mr258876/PRISM-Film-Scanner/Resources/Imaging_Board_PoC.jpg

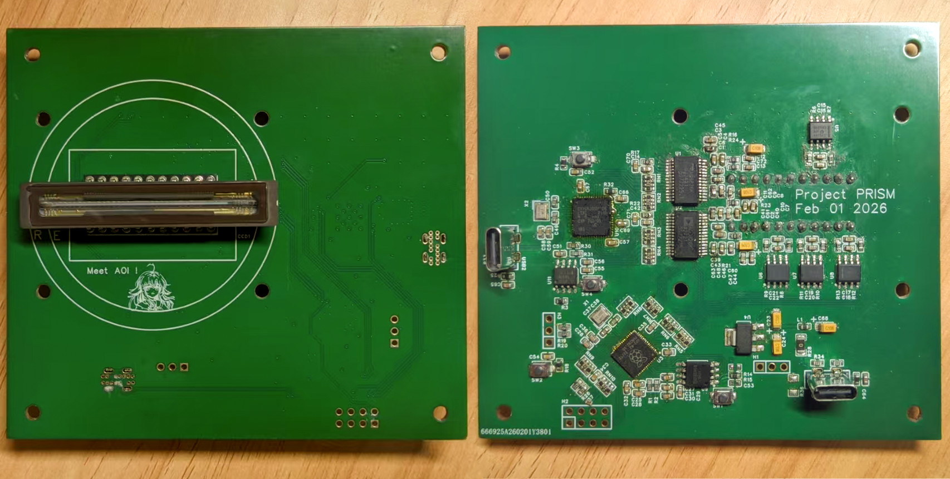
Resources/Imaging_Board_PoC.jpg
