mr258876/PRISM-Film-Scanner/103_Gantry_Framework/FrameCarrier.SLDASM

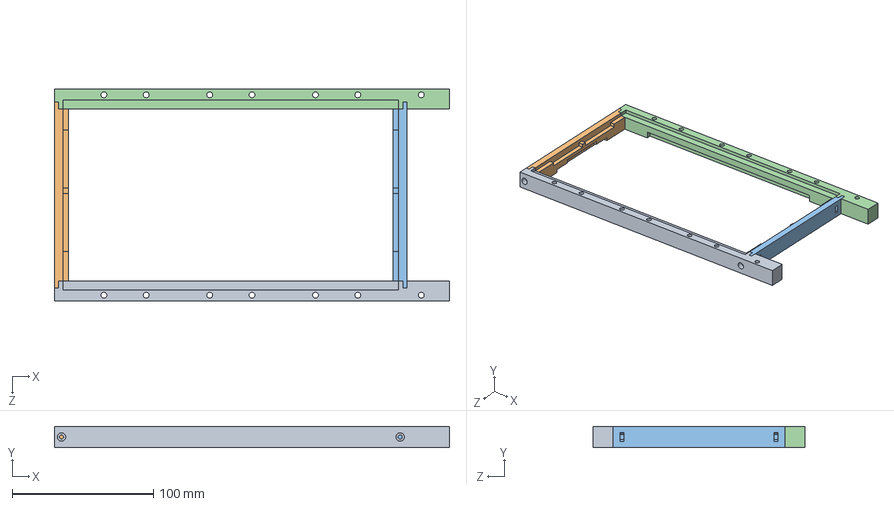
[picture p7: CAD file, 2026-05-15]
103_Gantry_Framework/FrameCarrier.SLDASM
280.0 x 15.0 x 150.0 mm
Film Carrier Frame D
Film Carrier Frame L
Film Carrier Frame R
Film Carrier Frame T
