mr258876/PRISM-Film-Scanner/103_Gantry_Framework/Framework.SLDASM

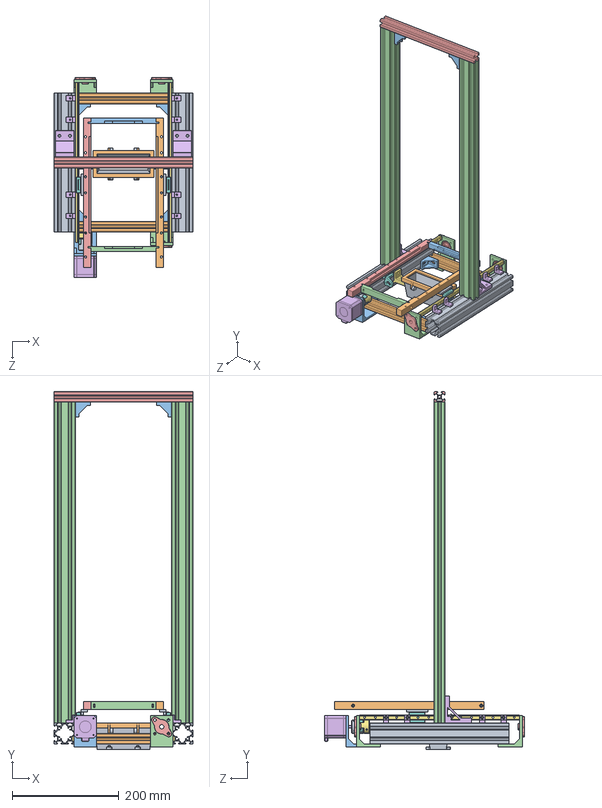
[picture p8: CAD file, 2026-05-15]
103_Gantry_Framework/Framework.SLDASM
260.0 x 670.0 x 374.0 mm
TXCJ-H7-4420-L260 x 2
TXCJ-H7-2020-L180 x 2
TPDB-206-2020-ZP x 6
TXCJ-H7-2040-L600 x 2
TXCJ-H7-2020-L260
Stands x 8
导轨^MGN9C-1-R-300-Z0-C-E10 x 2
滑块^MGN9C-1-R-300-Z0-C-E10 x 2
Film Carrier Frame Support x 2
Film Carrier Frame D
Film Carrier Frame L
Film Carrier Frame R
Film Carrier Frame T
TPDC3-206-5034-ZP x 2
Diffuser Support x 2
Film Carrier Flange Ring x 2
Diffuser
Diffuser Cap
Motor Mount
Screw Mount x 3
KFL08 x 3
42Stepper
主体1^CXHH-D25-d5-e8
调节环^CXHH-D25-d5-e8
主体2^CXHH-D25-d5-e8
