mr258876/PRISM-Film-Scanner/103_Gantry_Framework/MGN9C-1-R-300-Z0-C-E10.sldasm

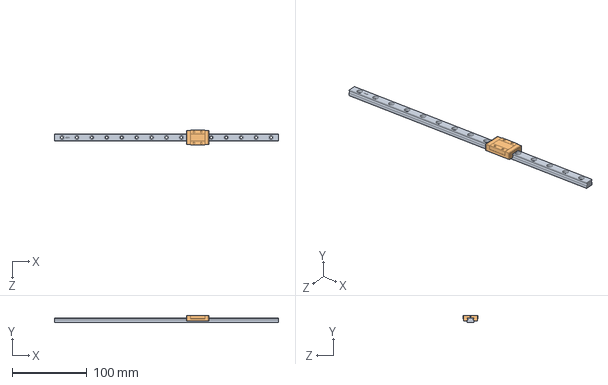
[picture p9: CAD file, 2026-05-15]
103_Gantry_Framework/MGN9C-1-R-300-Z0-C-E10.sldasm
300.0 x 10.0 x 20.0 mm
导轨^MGN9C-1-R-300-Z0-C-E10
滑块^MGN9C-1-R-300-Z0-C-E10
