mr258876/PRISM-Film-Scanner/103_Gantry_Framework/42Stepper.SLDPRT

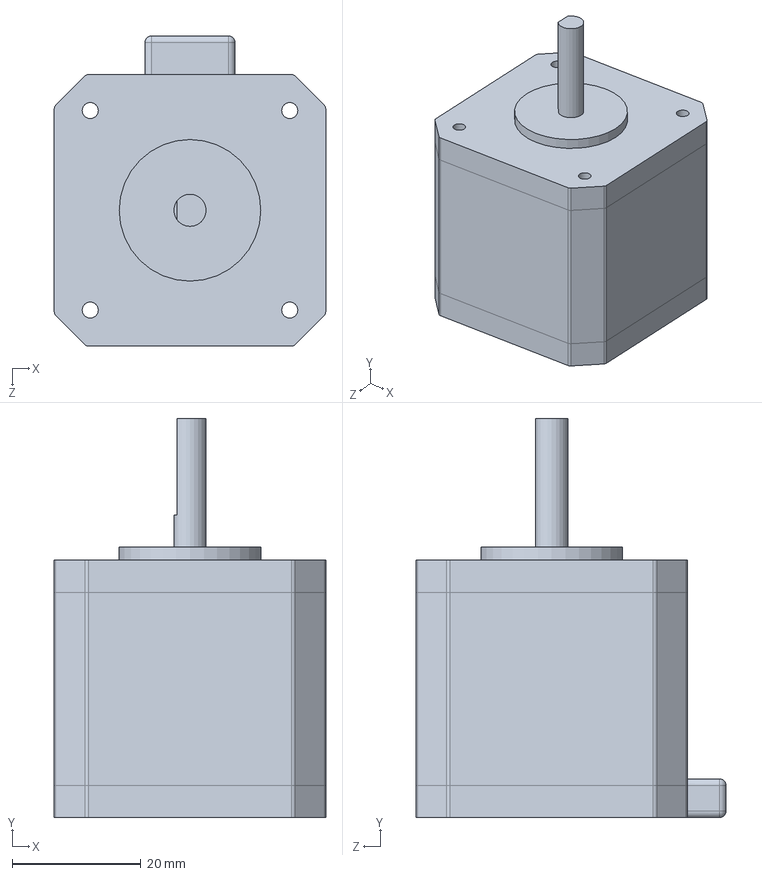
[picture p10: CAD file, 2026-05-15]
103_Gantry_Framework/42Stepper.SLDPRT
42.2 x 62.0 x 48.2 mm
