mr258876/PRISM-Film-Scanner/Lens Adapter/E-Adapter.STEP

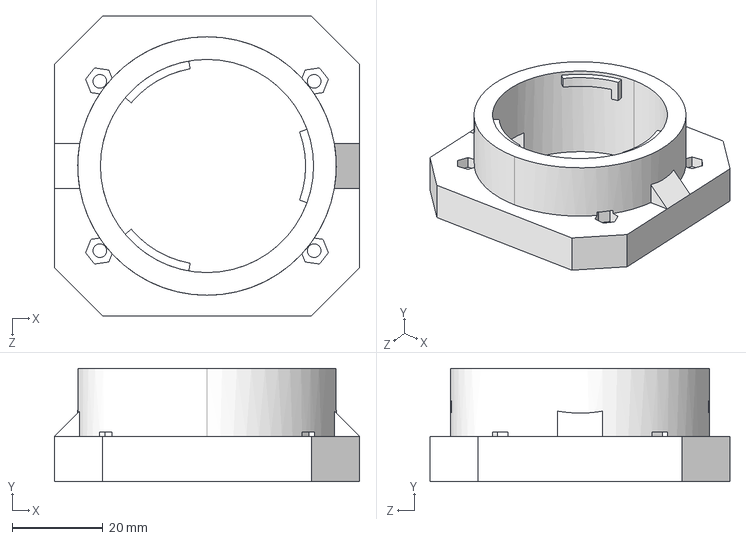
[picture p11: CAD file, 2026-03-14]
Lens Adapter/E-Adapter.STEP
67.2 x 25.0 x 66.1 mm
