mr258876/PRISM-Film-Scanner/103_Gantry_Framework/Film Carrier Frame T.SLDPRT

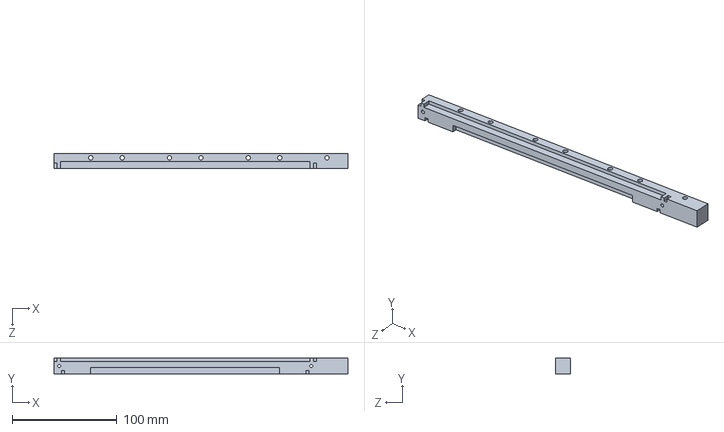
[picture p12: CAD file, 2026-05-15]
103_Gantry_Framework/Film Carrier Frame T.SLDPRT
280.0 x 15.0 x 14.0 mm
