mr258876/PRISM-Film-Scanner/103_Gantry_Framework/Film Carrier Frame.SLDPRT

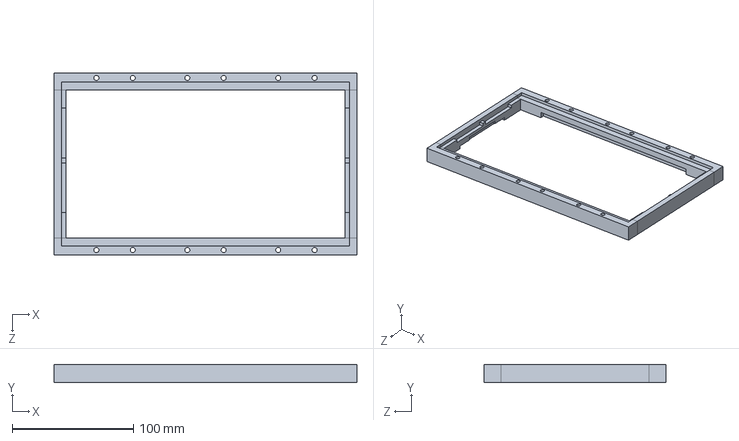
[picture p13: CAD file, 2026-05-15]
103_Gantry_Framework/Film Carrier Frame.SLDPRT
250.0 x 15.0 x 150.0 mm
