mr258876/PRISM-Film-Scanner/103_Gantry_Framework/TXCJ-H7-2040-L600.sldprt

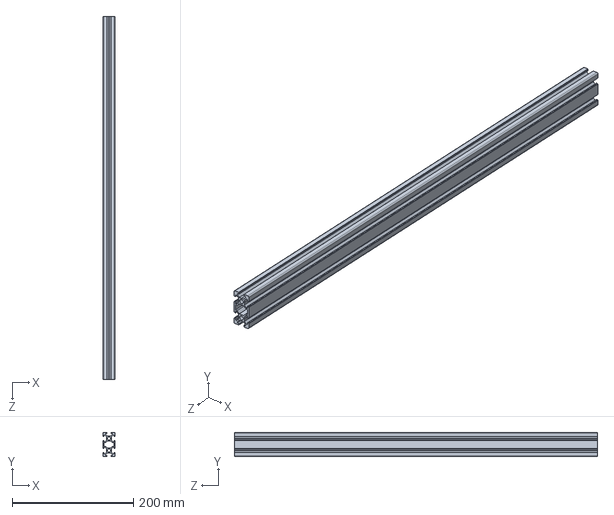
[picture p14: CAD file, 2026-05-15]
103_Gantry_Framework/TXCJ-H7-2040-L600.sldprt
20.0 x 40.0 x 600.0 mm
