mr258876/PRISM-Film-Scanner/103_Gantry_Framework/Scanner Mount.SLDPRT

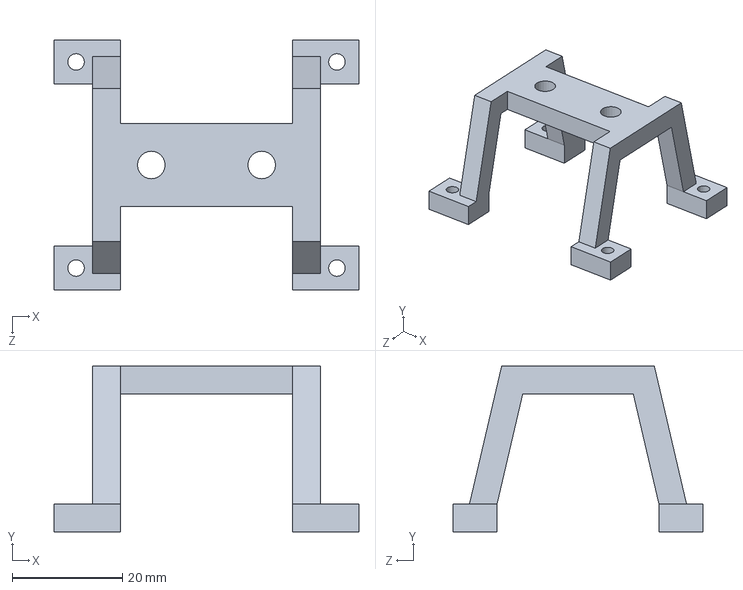
[picture p15: CAD file, 2026-05-15]
103_Gantry_Framework/Scanner Mount.SLDPRT
55.2 x 30.0 x 45.3 mm
