mr258876/PRISM-Film-Scanner/103_Gantry_Framework/Film Carrier Frame R.SLDPRT

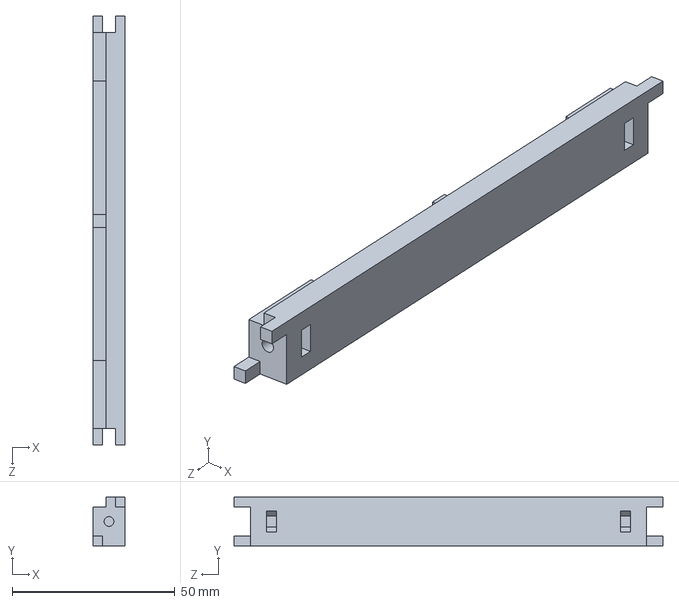
[picture p16: CAD file, 2026-05-15]
103_Gantry_Framework/Film Carrier Frame R.SLDPRT
10.00 x 15.0 x 132.0 mm
