mr258876/PRISM-Film-Scanner/103_Gantry_Framework/Diffuser.SLDPRT

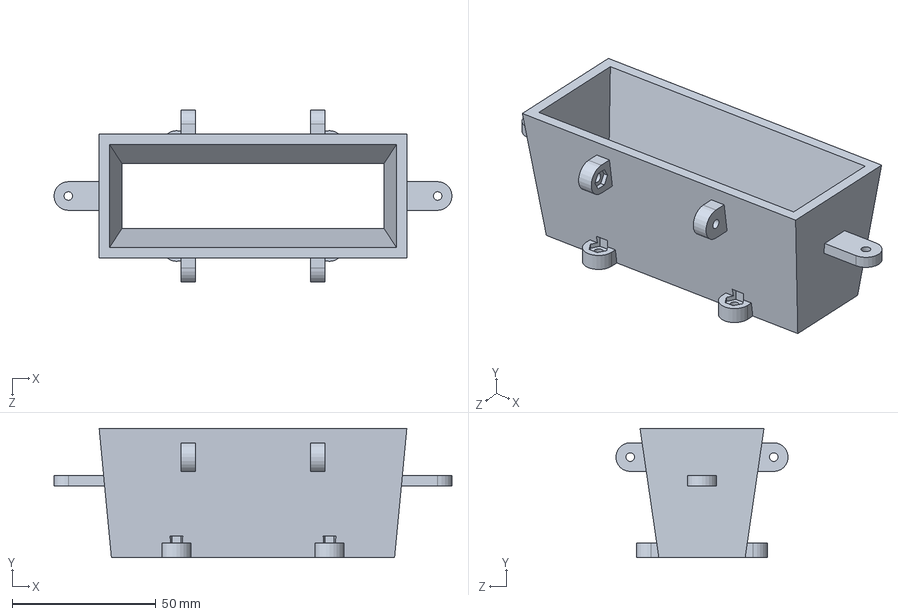
[picture p17: CAD file, 2026-05-15]
103_Gantry_Framework/Diffuser.SLDPRT
138.6 x 45.0 x 60.0 mm
