mr258876/PRISM-Film-Scanner/103_Gantry_Framework/TPDB-206-2020-ZP.sldprt

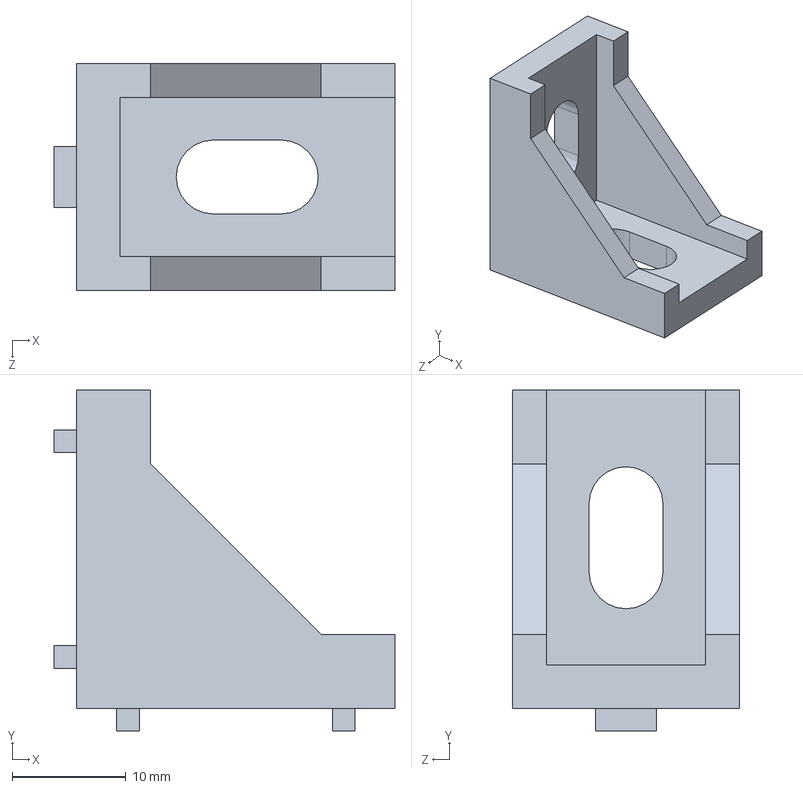
[picture p18: CAD file, 2026-05-15]
103_Gantry_Framework/TPDB-206-2020-ZP.sldprt
30.0 x 30.0 x 20.0 mm
