mr258876/PRISM-Film-Scanner/103_Gantry_Framework/Diffuser Support.SLDPRT

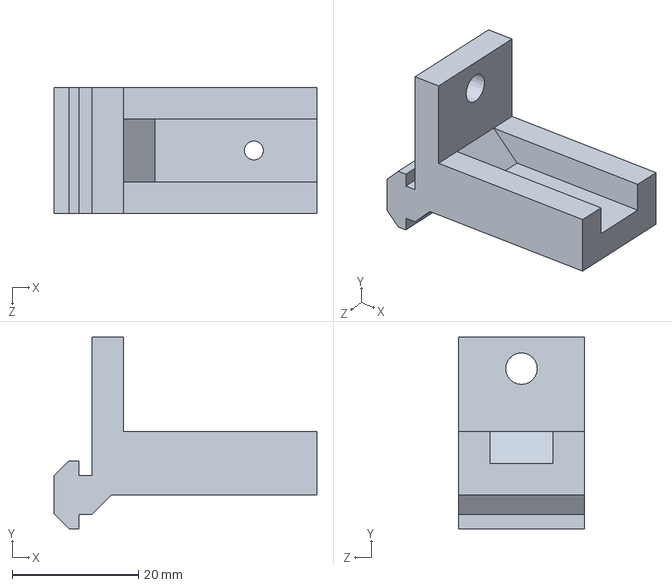
[picture p19: CAD file, 2026-05-15]
103_Gantry_Framework/Diffuser Support.SLDPRT
41.7 x 30.4 x 20.0 mm
