mr258876/PRISM-Film-Scanner/103_Gantry_Framework/TPDC3-206-5034-ZP.sldprt

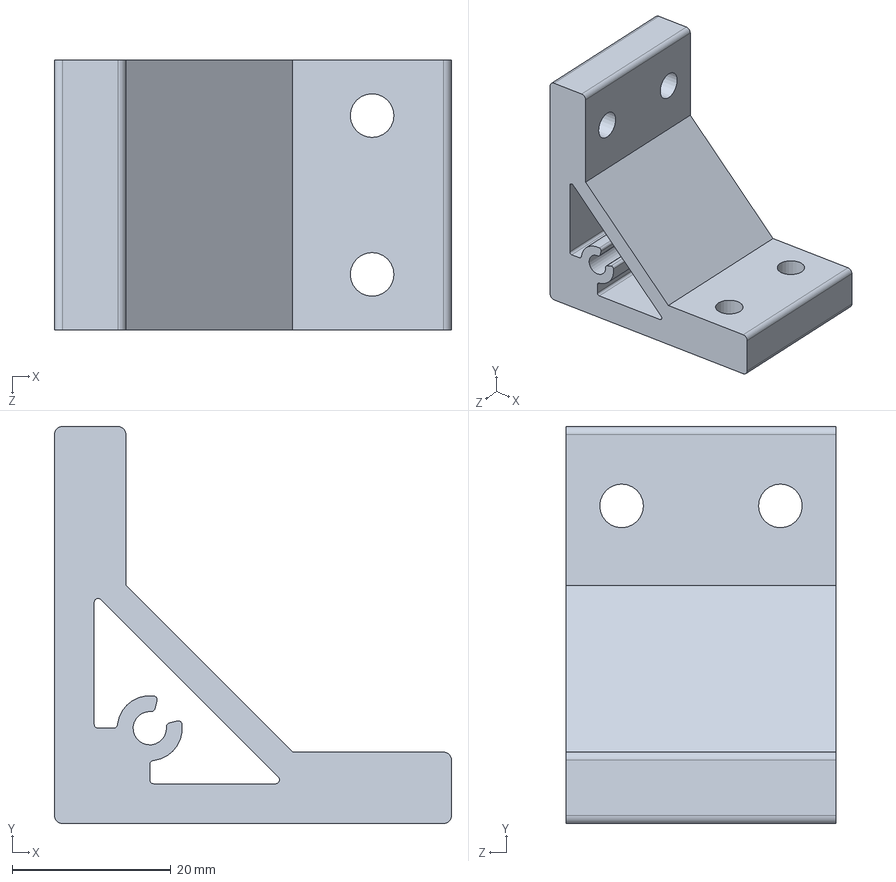
[picture p20: CAD file, 2026-05-15]
103_Gantry_Framework/TPDC3-206-5034-ZP.sldprt
50.0 x 50.0 x 34.0 mm
