mr258876/PRISM-Film-Scanner/103_Gantry_Framework/Film Carrier 35mm.SLDPRT

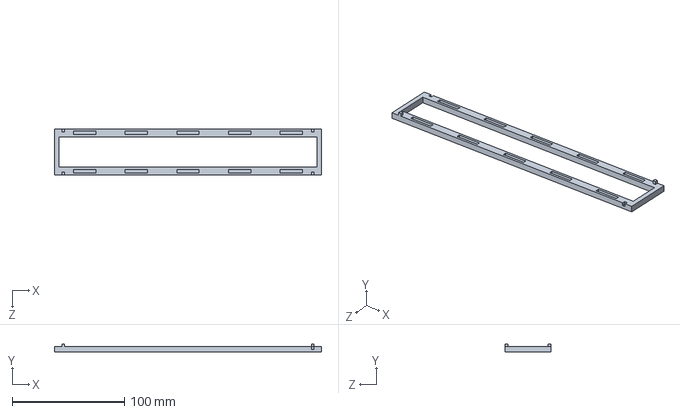
[picture p21: CAD file, 2026-05-15]
103_Gantry_Framework/Film Carrier 35mm.SLDPRT
238.0 x 7.50 x 41.0 mm
