mr258876/PRISM-Film-Scanner/103_Gantry_Framework/KFL08.SLDPRT

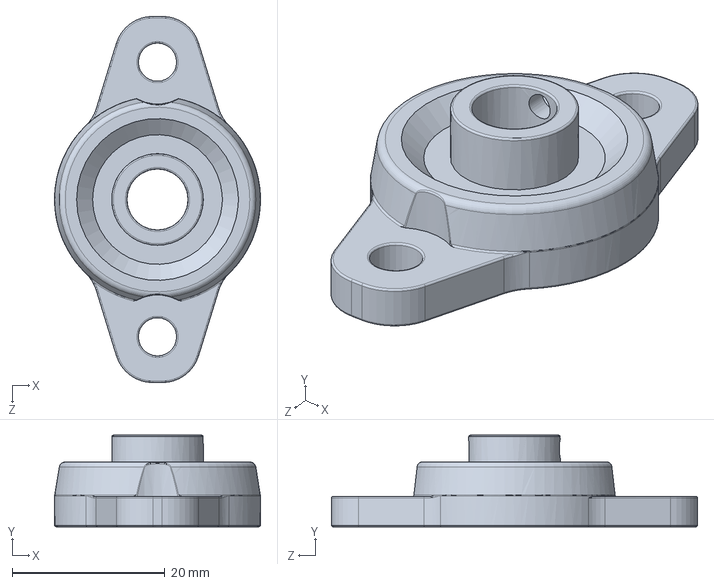
[picture p22: CAD file, 2026-05-15]
103_Gantry_Framework/KFL08.SLDPRT
27.0 x 12.0 x 48.0 mm
