mr258876/PRISM-Film-Scanner/103_Gantry_Framework/TXCJ-H7-2020-L260.sldprt

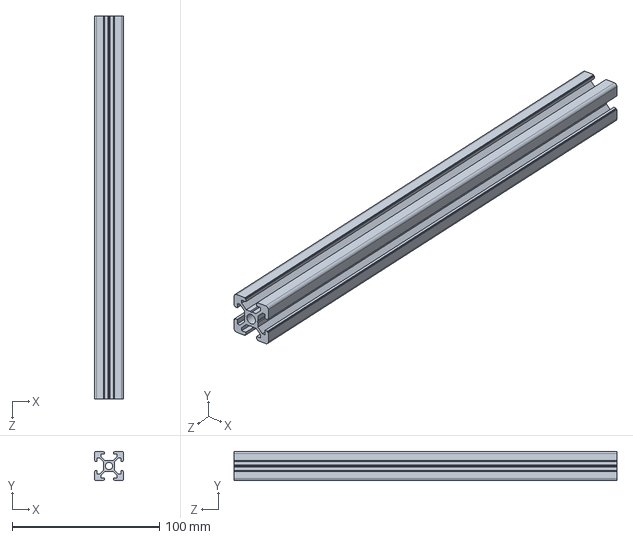
[picture p23: CAD file, 2026-05-15]
103_Gantry_Framework/TXCJ-H7-2020-L260.sldprt
20.0 x 20.0 x 260.0 mm
