mr258876/PRISM-Film-Scanner/103_Gantry_Framework/Diffuser Cap.SLDPRT

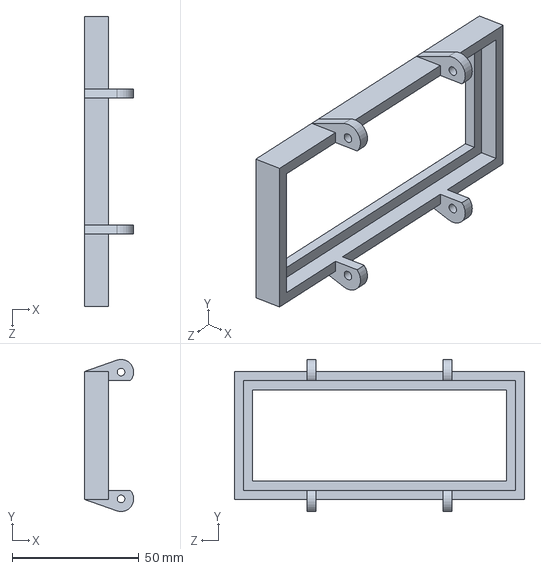
[picture p24: CAD file, 2026-05-15]
103_Gantry_Framework/Diffuser Cap.SLDPRT
19.5 x 60.0 x 114.4 mm
