mr258876/PRISM-Film-Scanner/103_Gantry_Framework/TXCJ-H7-4420-L260.sldprt

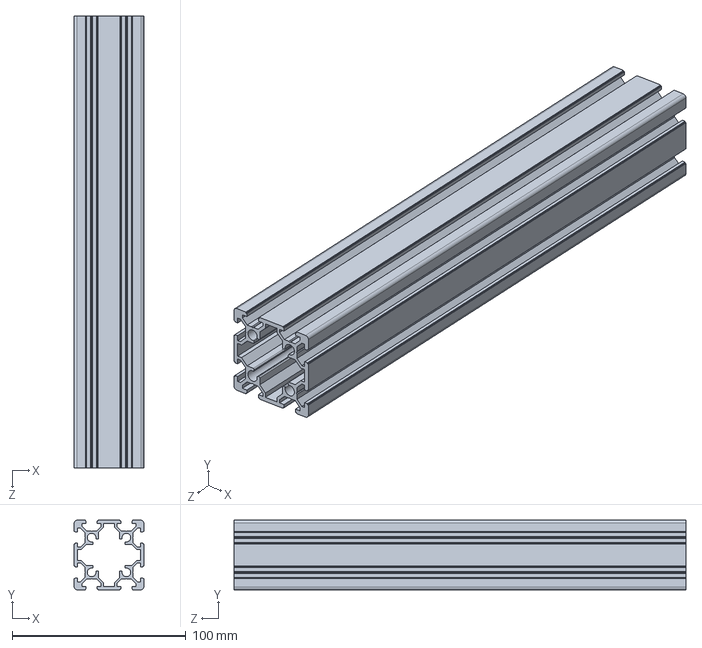
[picture p25: CAD file, 2026-05-15]
103_Gantry_Framework/TXCJ-H7-4420-L260.sldprt
40.0 x 40.0 x 260.0 mm
