mr258876/PRISM-Film-Scanner/103_Gantry_Framework/Motor Mount.SLDPRT

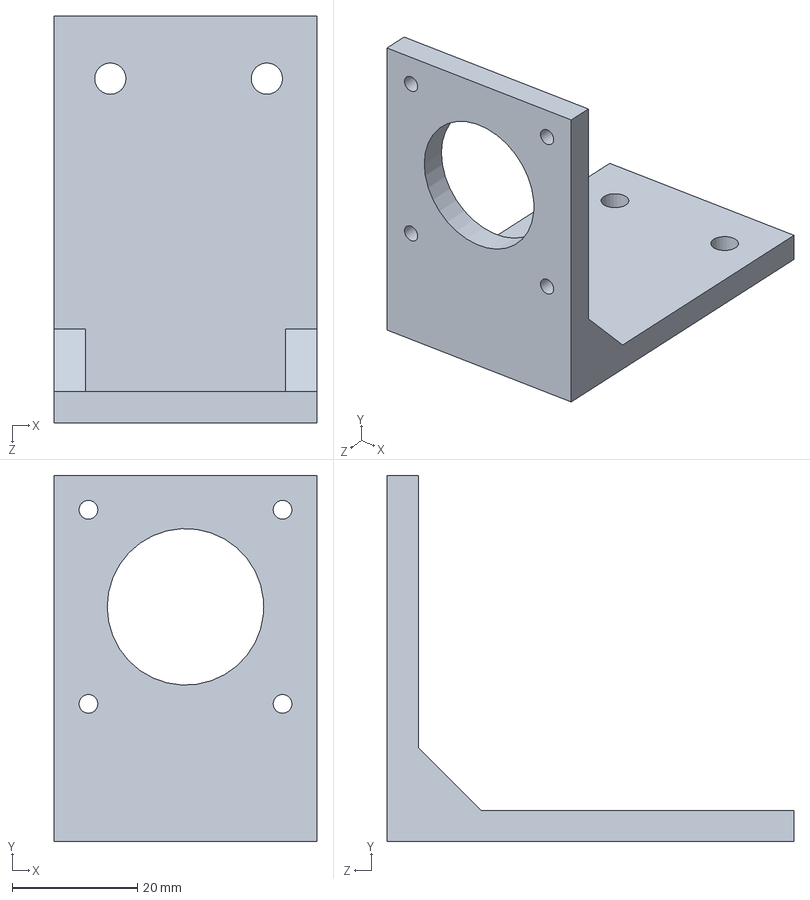
[picture p26: CAD file, 2026-05-15]
103_Gantry_Framework/Motor Mount.SLDPRT
42.0 x 58.5 x 65.0 mm
