mr258876/PRISM-Film-Scanner/103_Gantry_Framework/Stands.SLDPRT

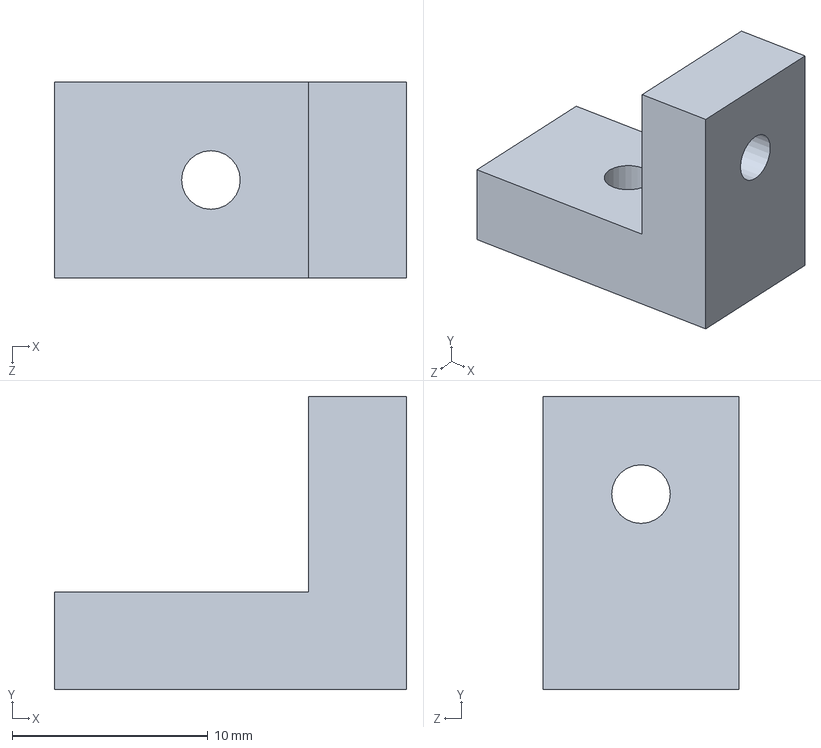
[picture p27: CAD file, 2026-05-15]
103_Gantry_Framework/Stands.SLDPRT
18.0 x 15.0 x 10.0 mm
