mr258876/PRISM-Film-Scanner/103_Gantry_Framework/Film Carrier Flange Ring.SLDPRT

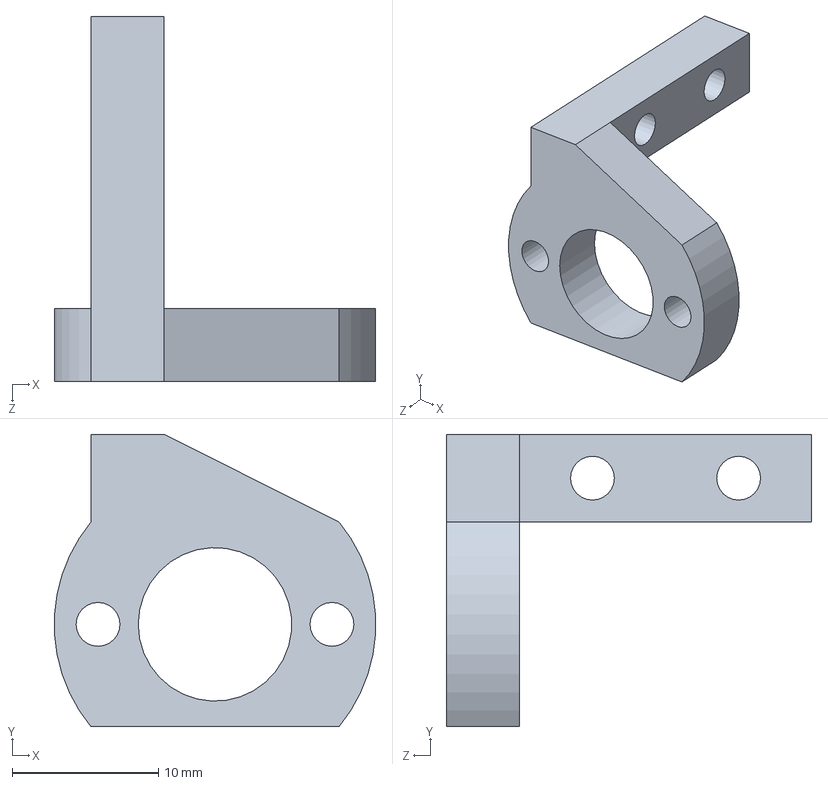
[picture p28: CAD file, 2026-05-15]
103_Gantry_Framework/Film Carrier Flange Ring.SLDPRT
22.0 x 20.0 x 25.0 mm
