mr258876/PRISM-Film-Scanner/103_Gantry_Framework/Film Carrier Frame Support.SLDPRT

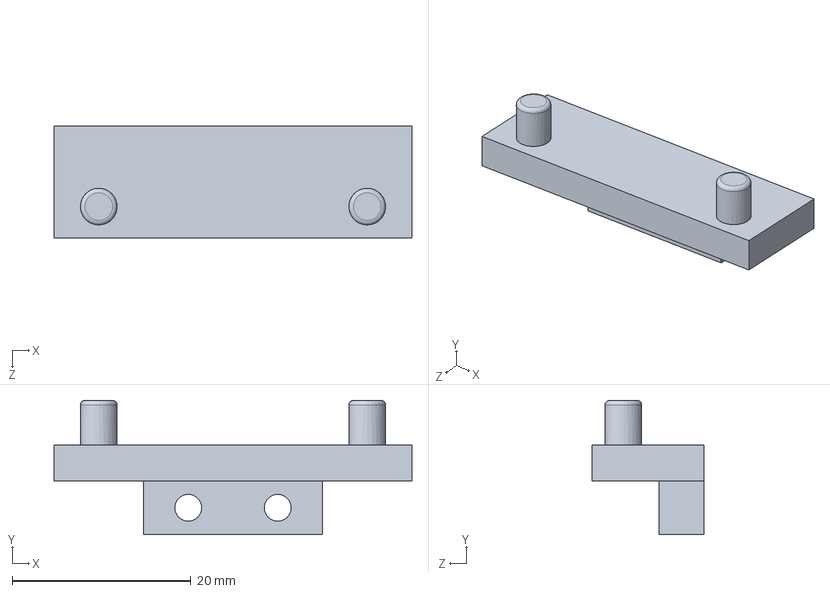
[picture p29: CAD file, 2026-05-15]
103_Gantry_Framework/Film Carrier Frame Support.SLDPRT
40.0 x 15.0 x 12.5 mm
