mr258876/PRISM-Film-Scanner/103_Gantry_Framework/TXCJ-H7-2020-L180.sldprt

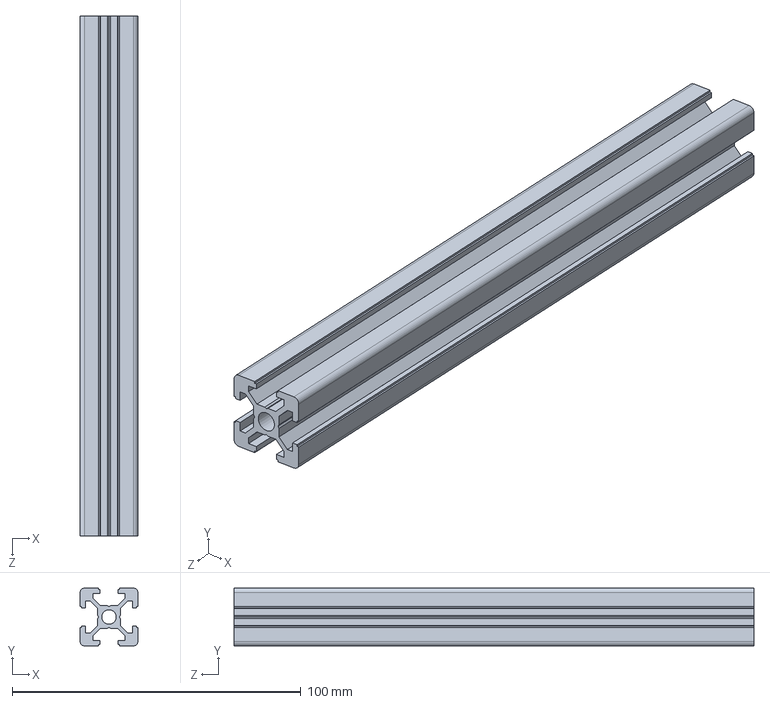
[picture p30: CAD file, 2026-05-15]
103_Gantry_Framework/TXCJ-H7-2020-L180.sldprt
20.0 x 20.0 x 180.0 mm
