mr258876/PRISM-Film-Scanner/103_Gantry_Framework/CXHH-D25-d5-e8.sldasm

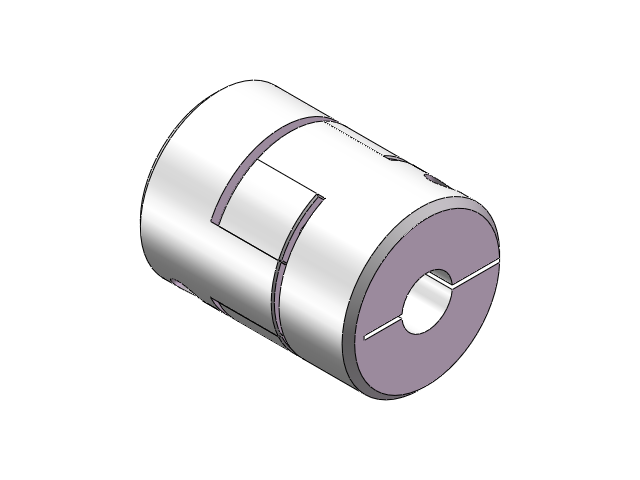
[picture p31: CAD file, 2026-05-15]
103_Gantry_Framework/CXHH-D25-d5-e8.sldasm
主体1^CXHH-D25-d5-e8
调节环^CXHH-D25-d5-e8
主体2^CXHH-D25-d5-e8
