mr258876/PRISM-Film-Scanner/(list of files, cad)

Other CAD files:
103_Gantry_Framework/E-Adapter.SLDPRT
103_Gantry_Framework/Film Carrier Frame D.SLDPRT
103_Gantry_Framework/Film Carrier Frame L.SLDPRT
103_Gantry_Framework/Screw Mount.SLDPRT
