mr258876/PRISM-Film-Scanner/101_BackLight_Hardware/SCH_PRISM101 Backlight 4x4 RGBW_2026-04-10.pdf

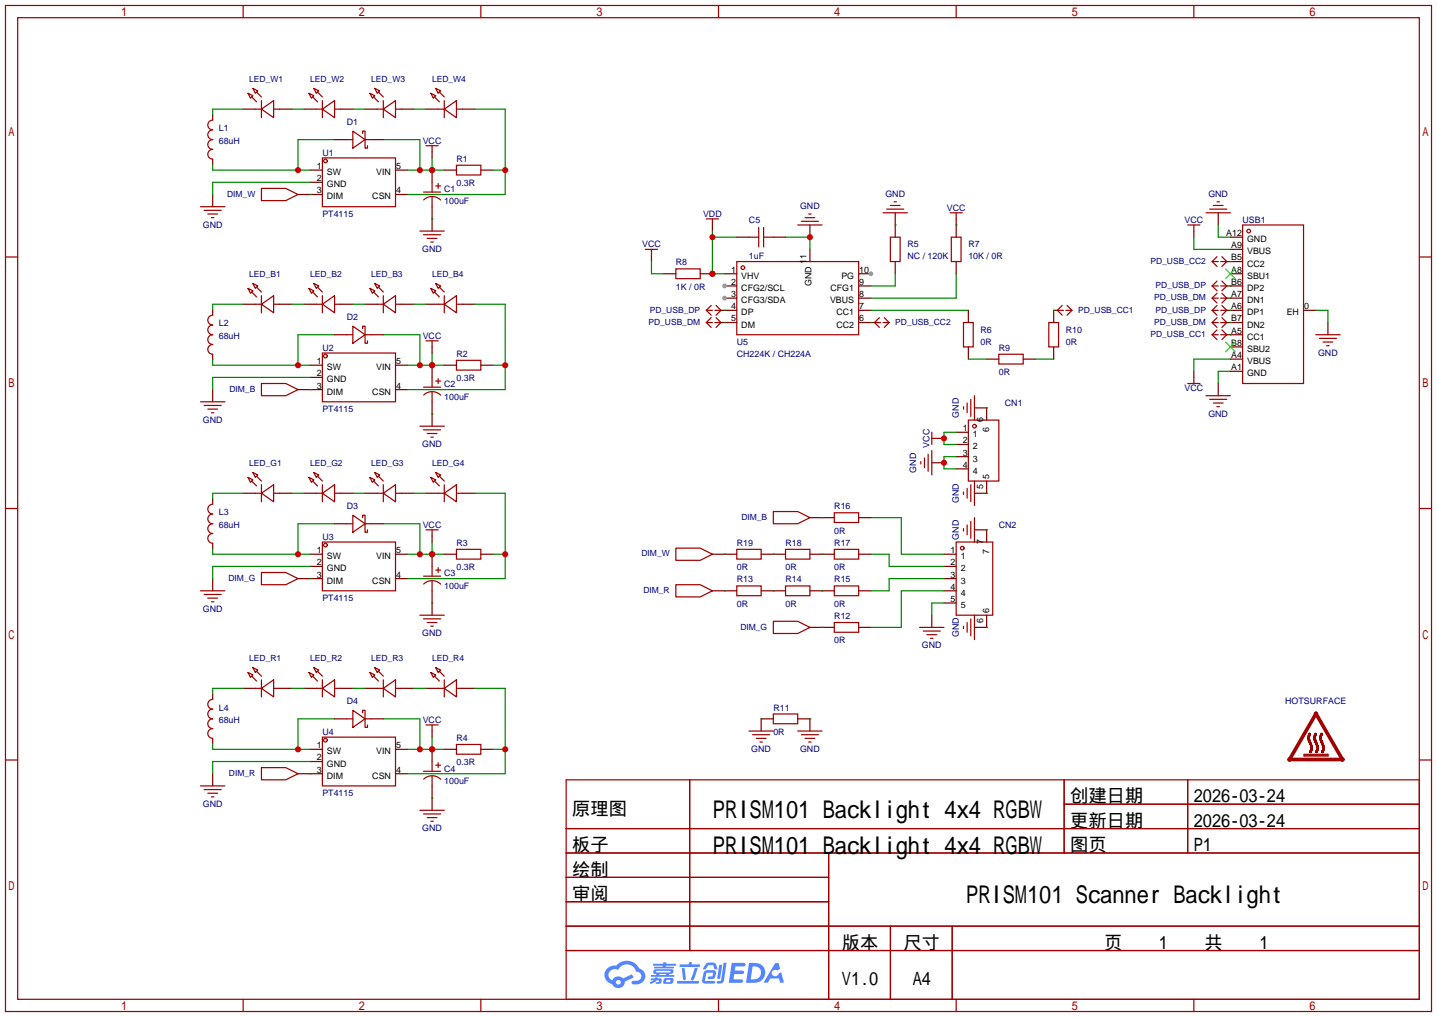
[picture p32: page 1]

GND GND

原理图 | PRISM101 Backlight 4x4 RGBW | 创建日期 | 2026-03-24
板子 | PRISM101 Backlight 4x4 RGBW | 图页 | P1
绘制 | | PRISM101 Scanner Backlight
审阅

更新日期 | 2026-03-24
