mr258876/PRISM-Film-Scanner/101_BackLight_Hardware/SCH_PRISM101 Backlight 4x6 RGBIR_2026-04-10.pdf

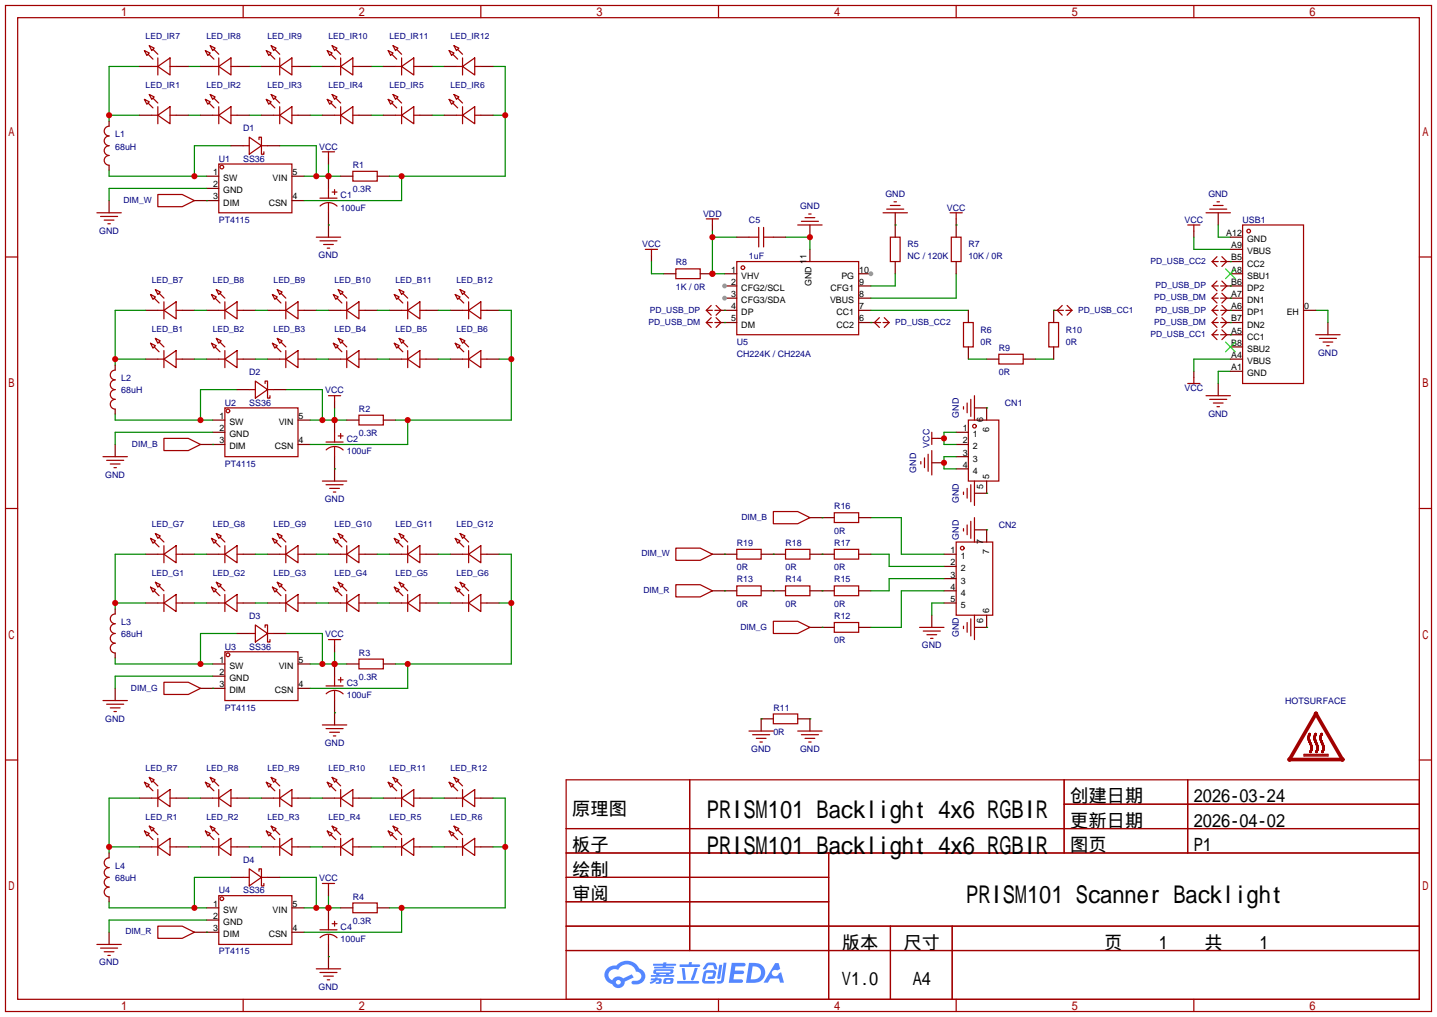
[picture p33: page 1]

GND GND

原理图 | PRISM101 Backlight 4x6 RGBIR | 创建日期 | 2026-03-24
板子 | PRISM101 Backlight 4x6 RGBIR | 图页 | P1

更新日期 | 2026-04-02
