mr258876/PRISM-Film-Scanner/102_PeriControl_Hardware/SCH_Schematic1_2026-04-10.pdf

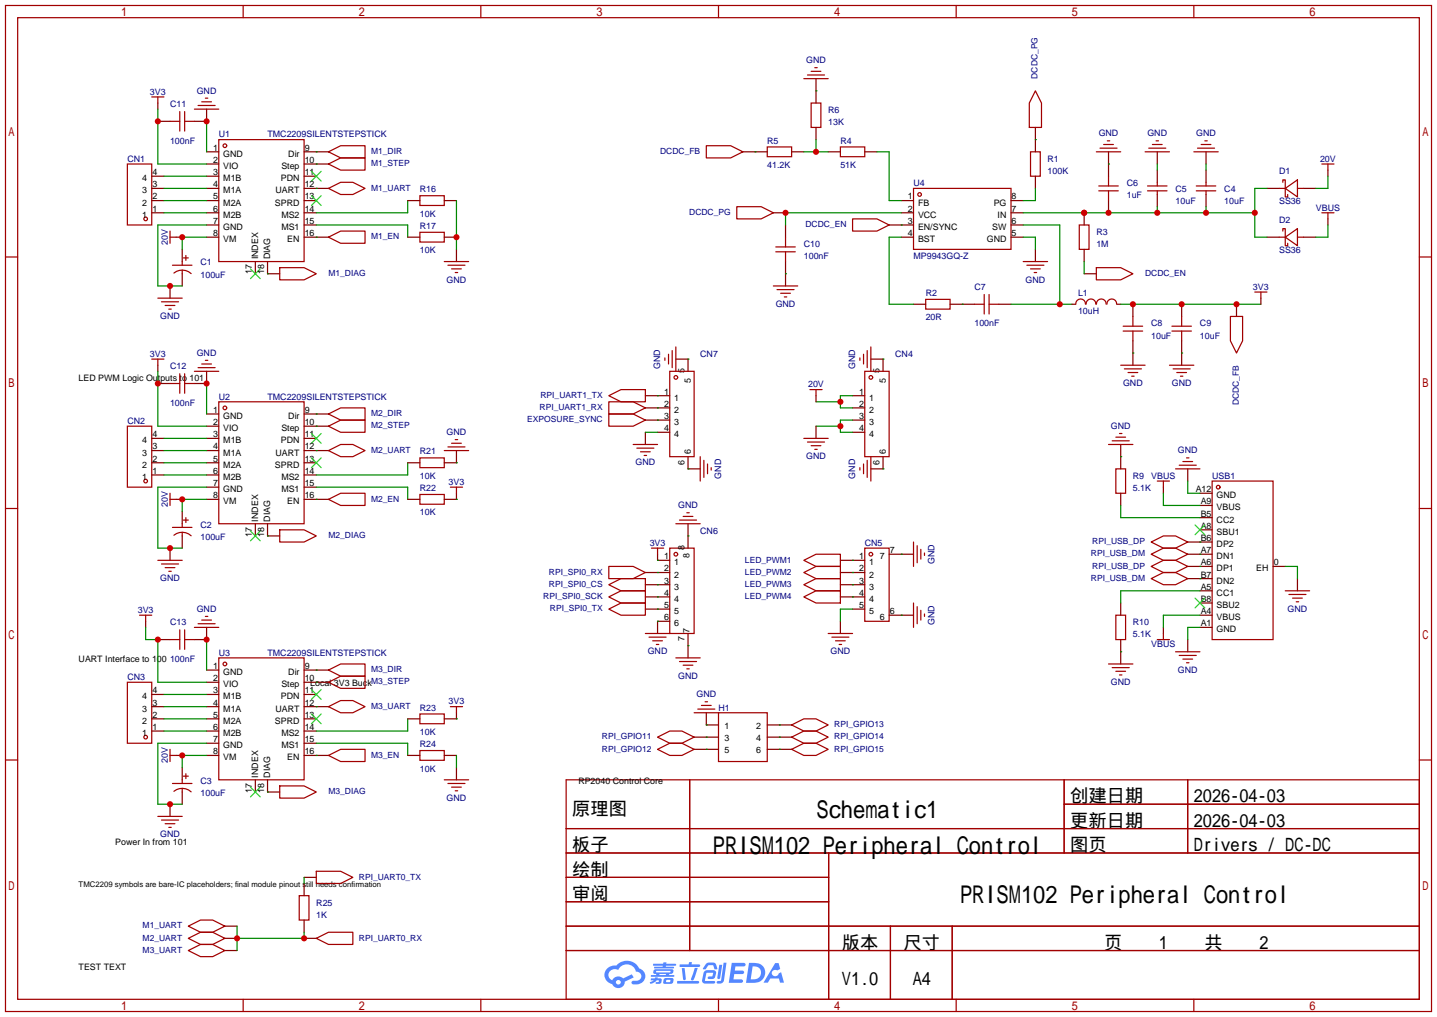
[picture p35: page 1]

LED PWM Logic Outputs to 101

原理图 | Schematic1 | 创建日期 | 2026-04-03
板子 | PRISM102 Peripheral Control | 图页 | Drivers / DC-DC
绘制 | | PRISM102 Peripheral Control
审阅

更新日期 | 2026-04-03

TMC2209 symbols are bare-IC placeholders; final module pinout still needs confirmation

# FLASH_SD0 FLASH_CS

## 1uFGND

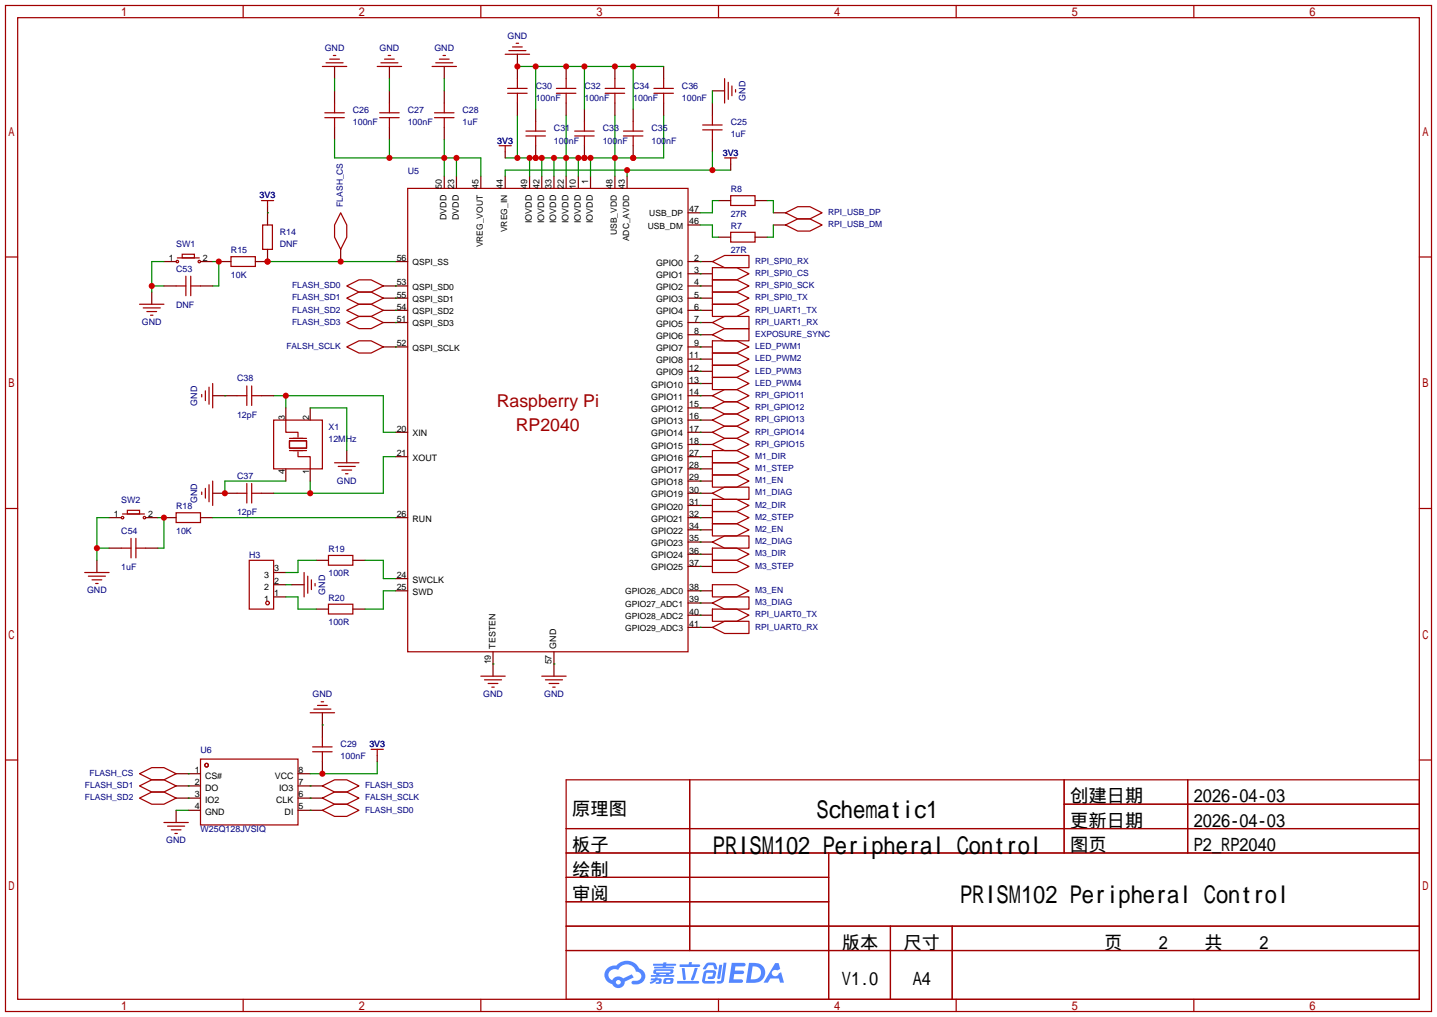
[picture p36: page 2]

原理图 | Schematic1 | 创建日期 | 2026-04-03
板子 | PRISM102 Peripheral Control | 图页 | P2_RP2040
绘制 | | PRISM102 Peripheral Control
审阅

更新日期 | 2026-04-03
