mr258876/PRISM-Film-Scanner/100_Scanner_Hardware/SCH_PRISM RP2040_2026-03-07.pdf

# Project PRISM Film Scanner

## Version: 0 Proof of Concept

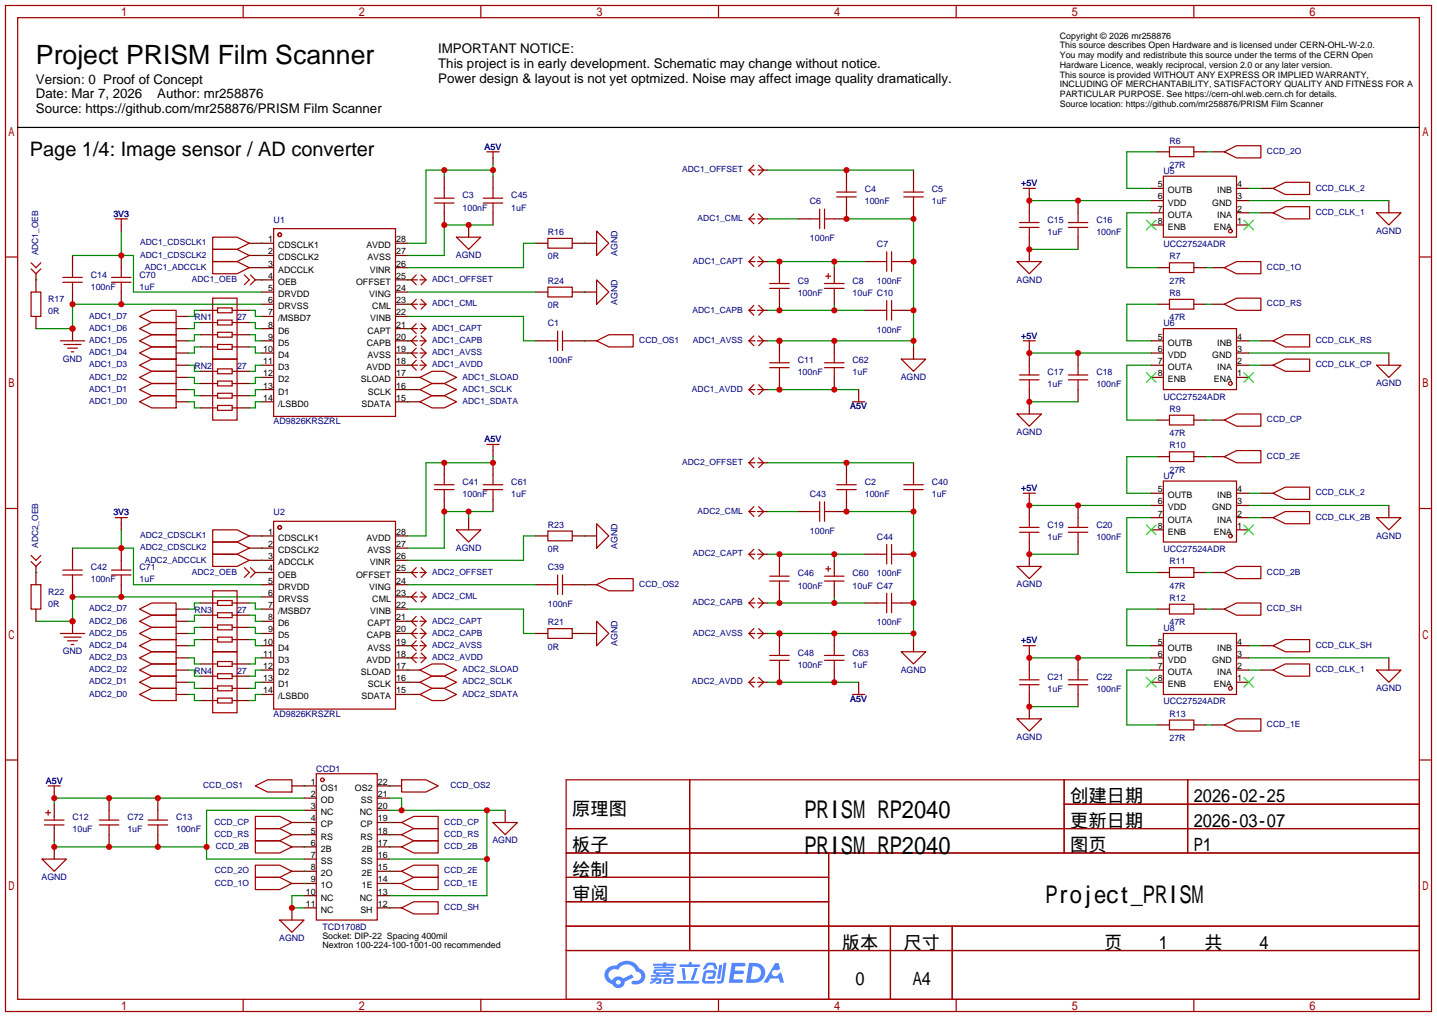
[picture p37: page 1]

Copyright © 2026 mr258876
This source describes Open Hardware and is licensed under CERN-OHL-W-2.0.
You may modify and redistribute this source under the terms of the CERN Open
Hardware Licence, weakly reciprocal, version 2.0 or any later version.
This source is provided WITHOUT ANY EXPRESS OR IMPLIED WARRANTY,
INCLUDING OF MERCHANTABILITY, SATISFACTORY QUALITY AND FITNESS FOR A
PARTICULAR PURPOSE. See https://cern-ohl.web.cern.ch for details.
Source location: https://github.com/mr258876/PRISM Film Scanner

IMPORTANT NOTICE:
This project is in early development. Schematic may change without notice.
Power design & layout is not yet optmized. Noise may affect image quality dramatically.

Date: Mar 7, 2026 Author: mr258876
Source: https://github.com/mr258876/PRISM Film Scanner
Page 1/4: Image sensor / AD converter

AGND AGND

原理图 | PRISM RP2040 | 创建日期 | 2026-02-25
板子 | PRISM RP2040 | 图页 | P1
绘制 | | Project_PRISM
审阅

更新日期 | 2026-03-07

## 1uFGND

## Date: Mar 7, 2026 Author: mr258876

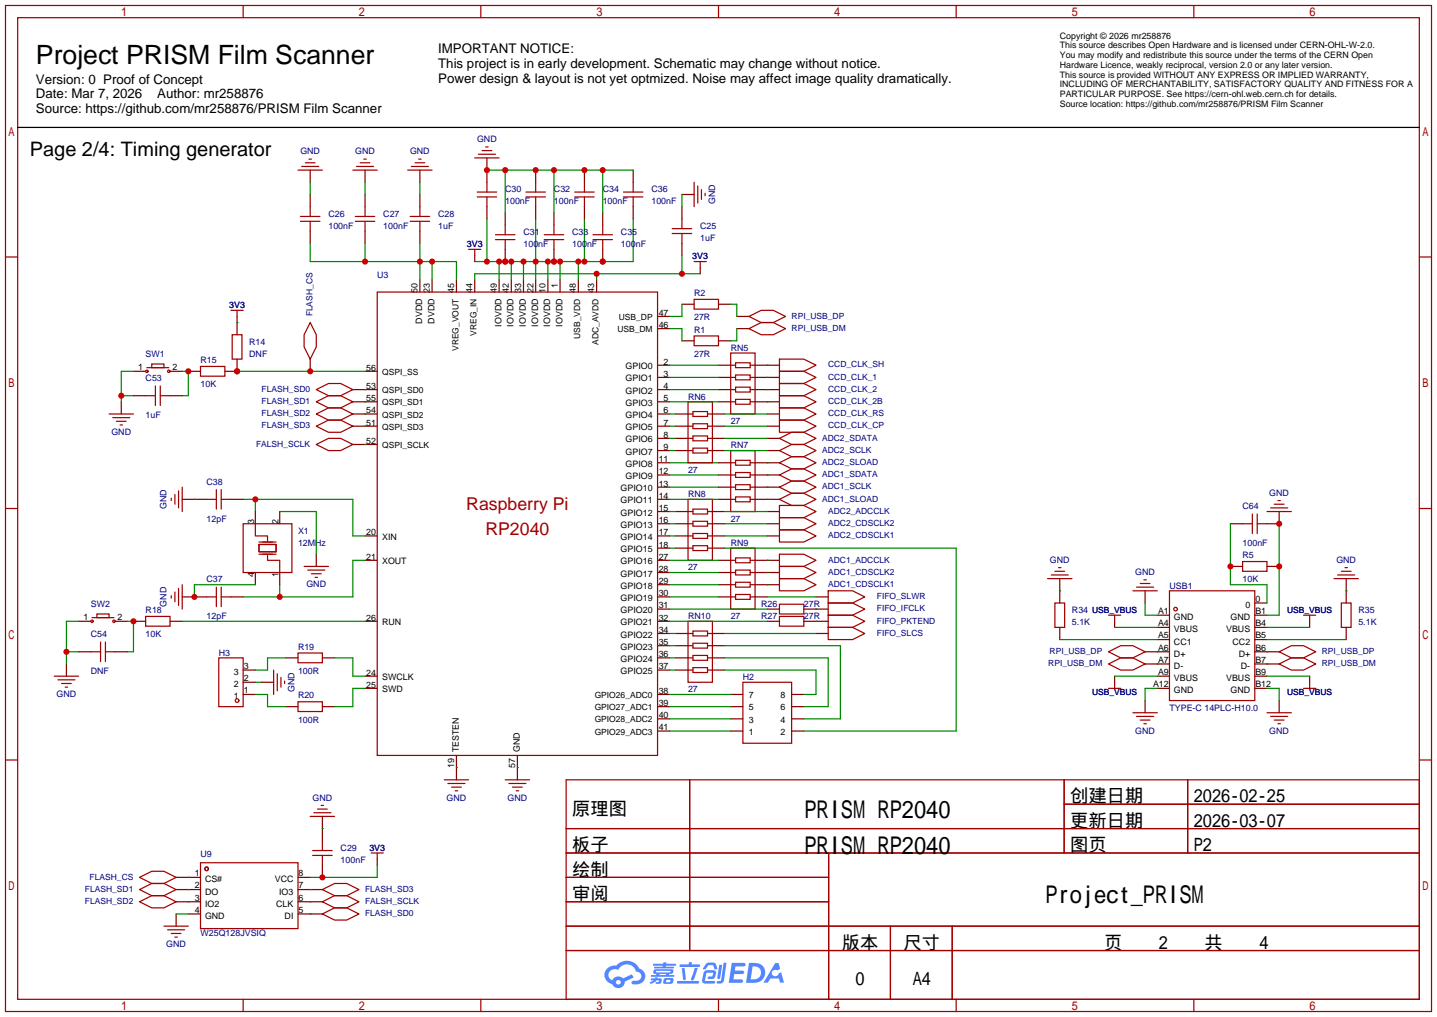
[picture p38: page 2]

Source: https://github.com/mr258876/PRISM Film Scanner
Page 2/4: Timing generator

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

原理图 | PRISM RP2040 | 创建日期 | 2026-02-25
板子 | PRISM RP2040 | 图页 | P2
绘制 | | Project_PRISM
审阅

更新日期 | 2026-03-07

## Date: Mar 7, 2026 Author: mr258876 Source: https://github.com/mr258876/PRISM Film Scanner

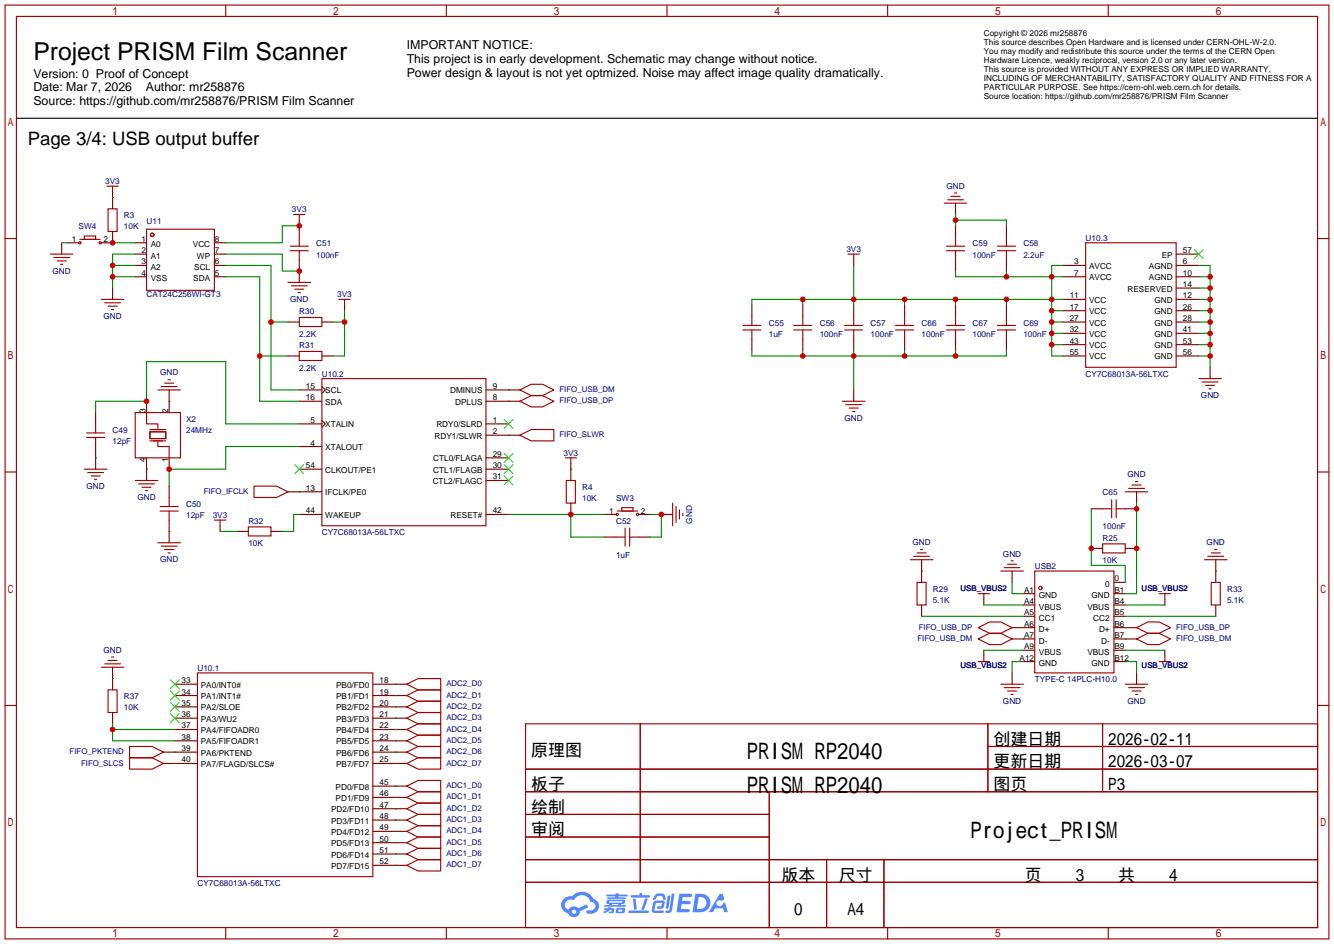
[picture p39: page 3]
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

Page 3/4: USB output buffer

原理图 | PRISM RP2040 | 创建日期 | 2026-02-11

更新日期 | 2026-03-07

绘制 | Project_PRISM
审阅

## Date: Mar 7, 2026 Author: mr258876 Source: https://github.com/mr258876/PRISM Film Scanner

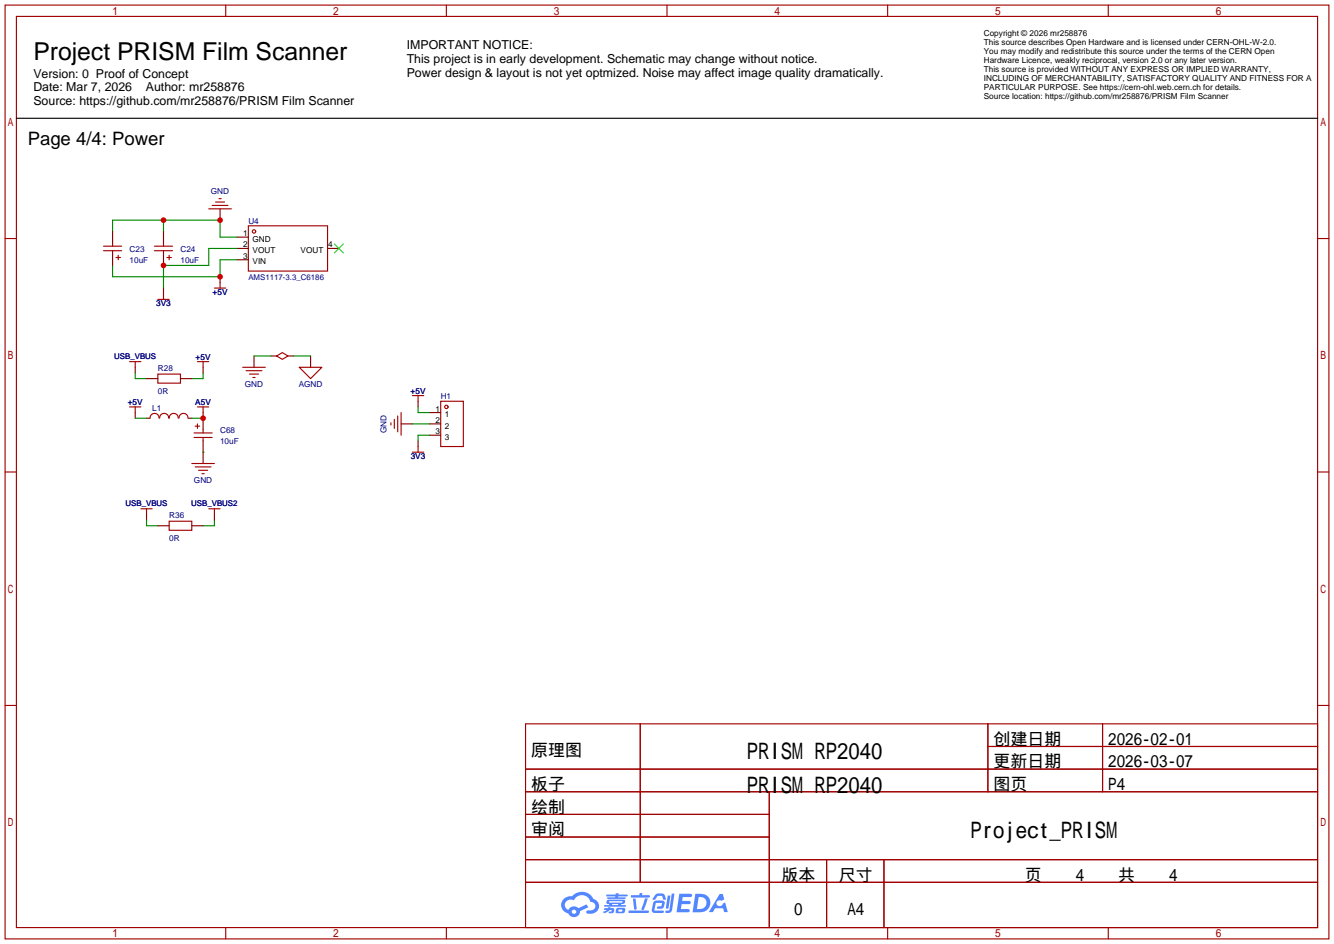
[picture p40: page 4]
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

原理图 | PRISM RP2040 | 创建日期 | 2026-02-01
板子 | PRISM RP2040 | 图页 | P4
绘制 | | Project_PRISM
审阅

更新日期 | 2026-03-07
