mr258876/PRISM-Film-Scanner/(list of files, drawings)

Other design files:
100_Scanner_Hardware/EadyEDA/ProPrj_Project_PRISM_2026-03-07.epro
101_BackLight_Hardware/ProPrj_PRISM101 Scanner Backlight_2026-04-10.epro
102_PeriControl_Hardware/ProPrj_PRISM102 Peripheral Control_2026-04-10.epro
