mr258876/PRISM-Film-Scanner/100_Scanner_Firmware/Project_PRISM_RP2040/Pinouts.h

/*
 * Copyright (c) 2026 mr258876
 * SPDX-License-Identifier: MIT
 */

#ifndef _PINOUTS_H_
#define _PINOUTS_H_

#define CCD_CLK_SH_PIN      0
#define CCD_CLK_1_PIN       1
#define CCD_CLK_2_PIN       2
#define CCD_CLK_2B_PIN      3
#define CCD_CLK_RS_PIN      4
#define CCD_CLK_CP_PIN      5

#define ADC2_SPI_DATA_PIN   6
#define ADC2_SPI_SCLK_PIN   7
#define ADC2_SPI_LOAD_PIN   8

#define ADC1_SPI_DATA_PIN   9
#define ADC1_SPI_SCLK_PIN   10
#define ADC1_SPI_LOAD_PIN   11

#define ADC2_ADCCLK_PIN     12
#define ADC2_CDSCLK2_PIN    13
#define ADC2_CDSCLK1_PIN    14

#define EXPOSURE_SYNC_PIN   15

#define ADC1_ADCCLK_PIN     16
#define ADC1_CDSCLK2_PIN    17
#define ADC1_CDSCLK1_PIN    18

#define FIFO_SLWR_PIN       19
#define FIFO_IFCLK_PIN      20
#define FIFO_PKTEND_PIN     21
#define FIFO_SLCS_PIN       22

#define PERICONTROL_UART_TX_PIN 28
#define PERICONTROL_UART_RX_PIN 29

#endif
