mr258876/PRISM-Film-Scanner/100_Scanner_Firmware/Project_PRISM_RP2040/AD9826_SPI/AD9826_Reg.h

#ifndef _AD9826_REG_H_
#define _AD9826_REG_H_

#define AD9826_REG_CONFIG 0b000
#define AD9826_REG_MUX 0b001
#define AD9826_REG_GAIN_R 0b010
#define AD9826_REG_GAIN_G 0b011
#define AD9826_REG_GAIN_B 0b100
#define AD9826_REG_OFFSET_R 0b101
#define AD9826_REG_OFFSET_G 0b110
#define AD9826_REG_OFFSET_B 0b111

#define AD9826_REG_DATA_MASK 0x01FFu

#endif // _AD9826_REG_H_
