mr258876/PRISM-Film-Scanner/100_Scanner_Firmware/Project_PRISM_RP2040/tusb_config.h

/*
 * Copyright (c) 2026 mr258876
 * SPDX-License-Identifier: MIT
 */

#ifndef _TUSB_CONFIG_H_
#define _TUSB_CONFIG_H_

#ifdef __cplusplus
extern "C" {
#endif

#include "pico/stdlib.h"

#define CFG_TUSB_MCU                OPT_MCU_RP2040
#define CFG_TUSB_RHPORT0_MODE       (OPT_MODE_DEVICE)
#define CFG_TUSB_OS                 OPT_OS_PICO

#ifndef CFG_TUSB_DEBUG
#define CFG_TUSB_DEBUG              0
#endif

#define CFG_TUD_ENABLED             1

#define CFG_TUD_CDC                 0
#define CFG_TUD_MSC                 0
#define CFG_TUD_HID                 0
#define CFG_TUD_MIDI                0
#define CFG_TUD_VENDOR              1

#define CFG_TUD_ENDPOINT0_SIZE      64

#define CFG_TUD_VENDOR_EPSIZE       64
#define CFG_TUD_VENDOR_RX_BUFSIZE   256
#define CFG_TUD_VENDOR_TX_BUFSIZE   256

#ifdef __cplusplus
}
#endif

#endif
