mr258876/PRISM-Film-Scanner/(commit log)

2026-03-07 Proof of concept
    [ProPrj_Project_PRISM_2026-03-07.epro, Project_PRISM_CY7C68103A.obj, State Machine Sequence.xlsx, USBJmpTb.obj, dscr.obj, fw.obj]
2026-03-07 fix gitignore
    [Project_PRISM_CY7C68103A.obj, USBJmpTb.obj, dscr.obj, fw.obj]
2026-03-07 Gerber update
2026-03-07 Readme update
    [State Machine Sequence.xlsx]
2026-03-08 Add PoC board image
2026-03-10 Change pixel cycles from 3797 to 3801
    [State Machine Sequence.xlsx]
2026-03-11 fix line byte length in marco
    [Project_PRISM_RP2040.c]
2026-03-12 Update SM1 timing sequence for stability
    [State Machine Sequence.xlsx]
2026-03-12 improve timing to reduce dark current
    [State Machine Sequence.xlsx]
2026-03-13 seperate exposure_ticks with SH delay; allow underclocking; param storage with 2 pages
    [State Machine Sequence.xlsx]
2026-03-14 E-mount adapter
    [E-Adapter.STEP]
2026-04-10 project structure update
    [ProPrj_PRISM101 Scanner Backlight_2026-04-10.epro, ProPrj_PRISM102 Peripheral Control_2026-04-10.epro, ProPrj_Project_PRISM_2026-03-07.epro, State Machine Sequence.xlsx]
2026-04-14 LED protocol refine
2026-04-20 add motor init commands
2026-04-24 motor motion ACK & synced motion mode
2026-04-26 motor ack switch to async msg
2026-05-12 Switch motor control to PIO, interval in ns
2026-05-15 Gantry Framework
